Yanzzp/ESP_32/Tempest/OSR2-Pack-June22-password/STLs/OSR2.1/OSR2_1 Main Arm Beta1.stl

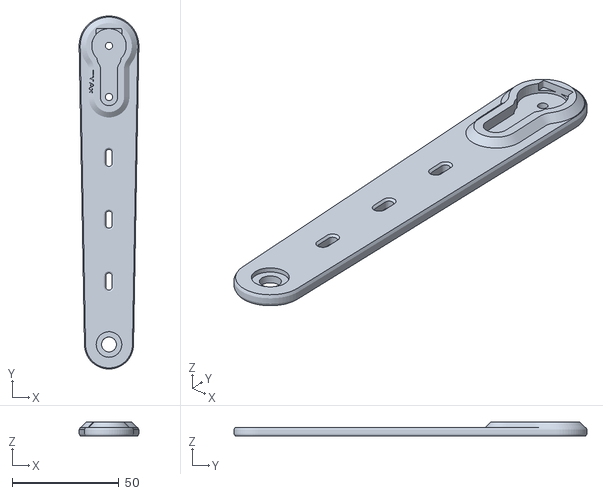
[picture p1: CAD file, 2023-10-18]
Tempest/OSR2-Pack-June22-password/STLs/OSR2.1/OSR2_1 Main Arm Beta1.stl
28.0 x 165.5 x 6.50
