Yanzzp/ESP_32/Tempest/SR6-Pack-June22-password/STLs/SR6 Alternate Parts/SR6 Main Link Alpha1.stl

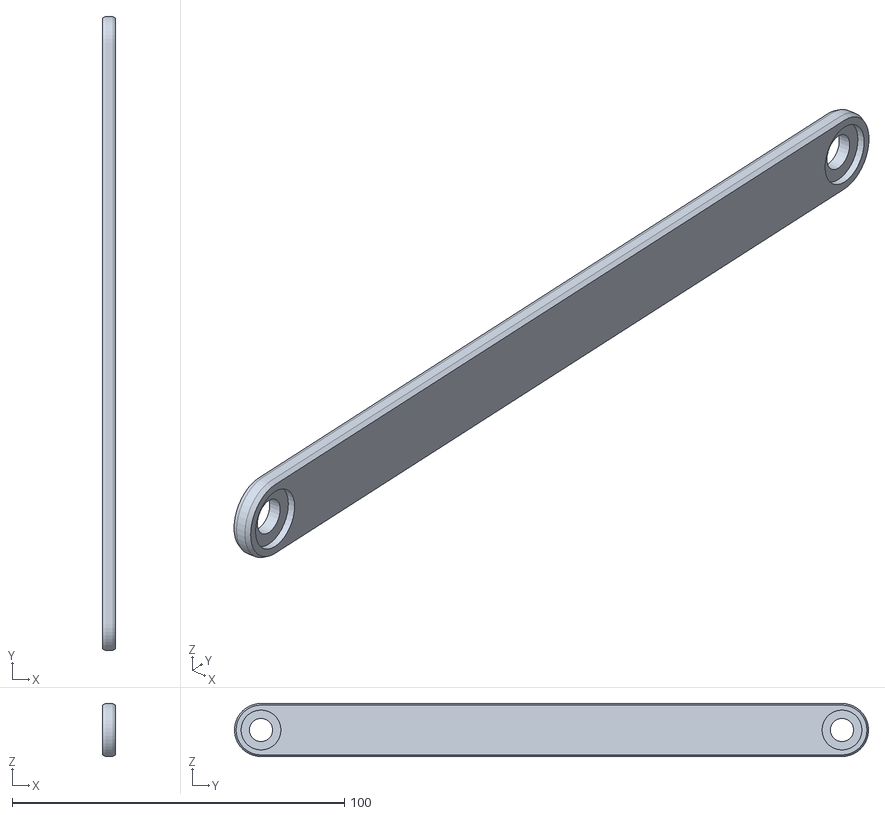
[picture p2: CAD file, 2023-10-18]
Tempest/SR6-Pack-June22-password/STLs/SR6 Alternate Parts/SR6 Main Link Alpha1.stl
4.00 x 191.0 x 16.0
