Yanzzp/ESP_32/Tempest/SR6-Pack-June22-password/STLs/SR6 Beta Parts/SR6 Bearing Main Link Beta1.stl

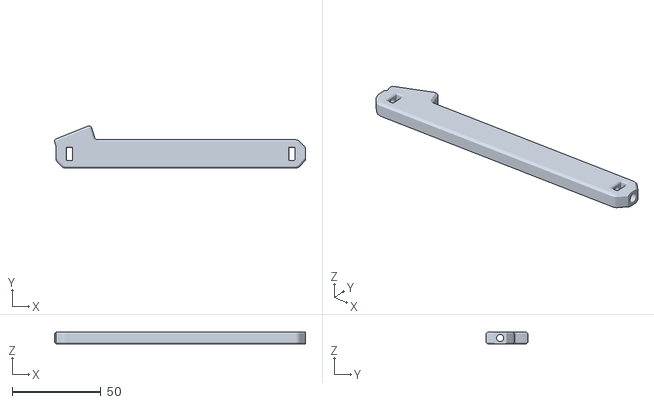
[picture p3: CAD file, 2023-10-18]
Tempest/SR6-Pack-June22-password/STLs/SR6 Beta Parts/SR6 Bearing Main Link Beta1.stl
141.8 x 23.8 x 7.00
