Yanzzp/ESP_32/Tempest/FS Case/FS Case/FS Case Body Alpha1.stl

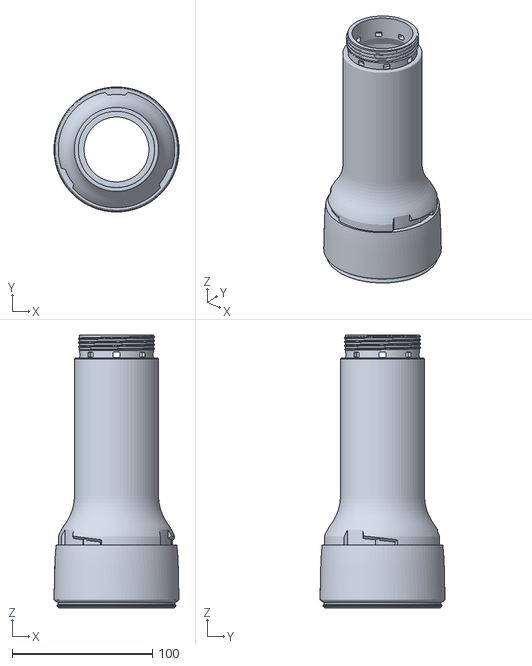
[picture p4: CAD file, 2023-10-18]
Tempest/FS Case/FS Case/FS Case Body Alpha1.stl
89.0 x 89.1 x 194.5
