Yanzzp/ESP_32/Tempest/OSR2-Pack-June22-password/STLs/OSR2 Bearing Arms/OSR2 Bearing Arm Beta1.stl

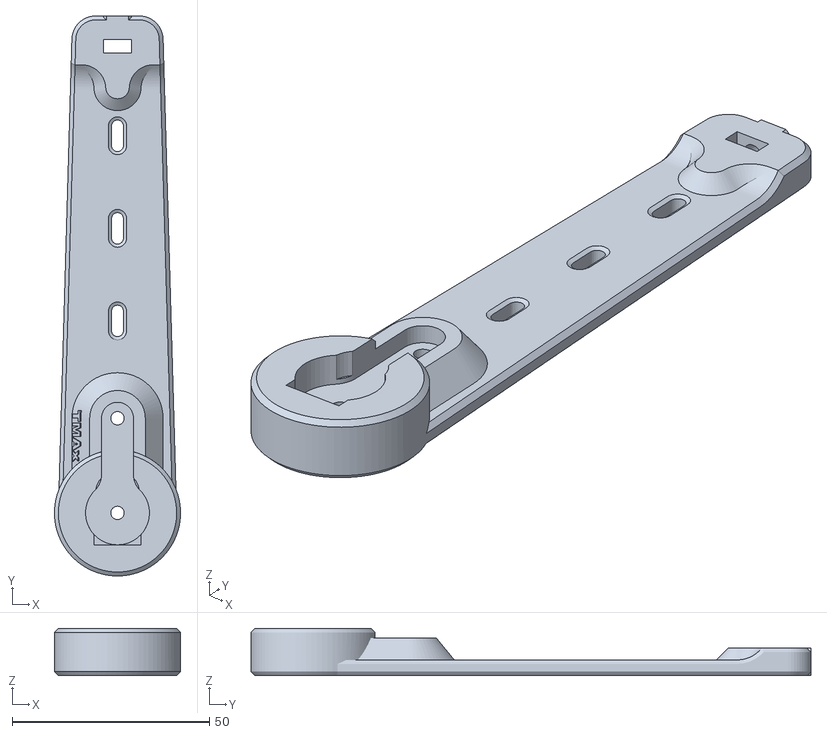
[picture p5: CAD file, 2023-10-18]
Tempest/OSR2-Pack-June22-password/STLs/OSR2 Bearing Arms/OSR2 Bearing Arm Beta1.stl
32.0 x 142.0 x 12.0
