Yanzzp/ESP_32/Tempest/OSR2-Pack-June22-password/STLs/OSR2 Pitcher/OSR2 plus Spacer Beta1.stl

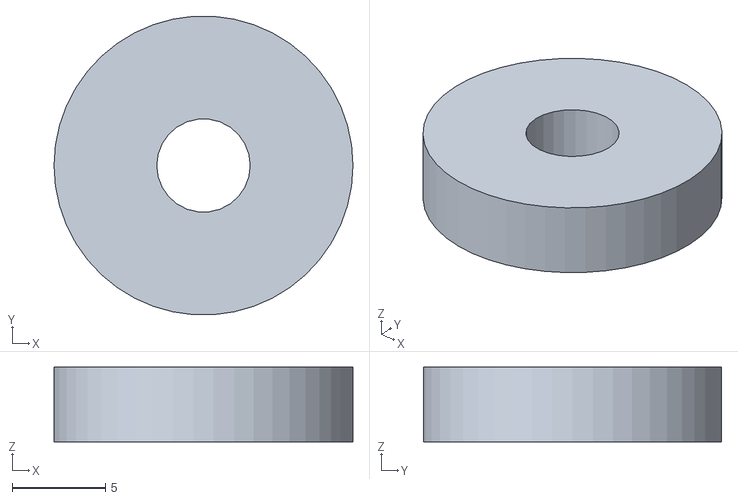
[picture p6: CAD file, 2023-10-18]
Tempest/OSR2-Pack-June22-password/STLs/OSR2 Pitcher/OSR2 plus Spacer Beta1.stl
16.0 x 16.0 x 4.00
