Yanzzp/ESP_32/Tempest/OSR2-Pack-June22-password/STLs/OSR2 T-valve/T-Valve Base Beta3.stl

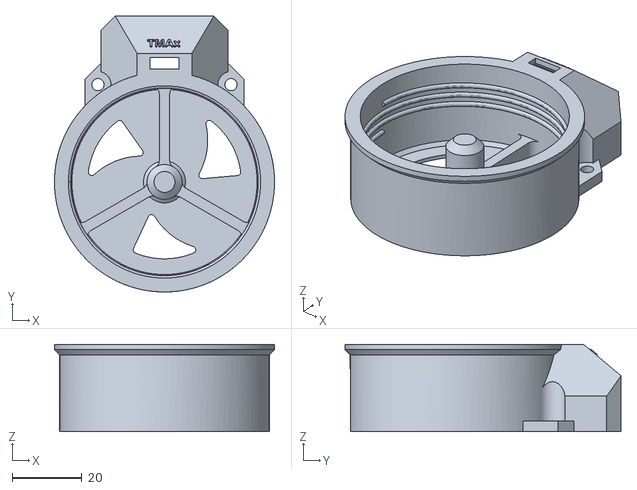
[picture p7: CAD file, 2023-10-18]
Tempest/OSR2-Pack-June22-password/STLs/OSR2 T-valve/T-Valve Base Beta3.stl
63.0 x 79.0 x 25.0
