Yanzzp/ESP_32/Tempest/OSR2-Pack-June22-password/STLs/OSR2 T-wist/T-wist4 Lid Beta1.stl

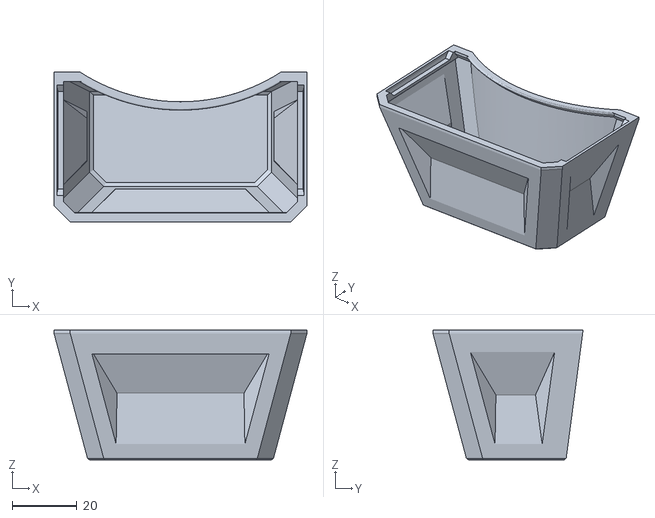
[picture p8: CAD file, 2023-10-18]
Tempest/OSR2-Pack-June22-password/STLs/OSR2 T-wist/T-wist4 Lid Beta1.stl
78.0 x 46.3 x 40.0
