Yanzzp/ESP_32/Tempest/SR6-Pack-June22-password/STLs/SR6 Beta Parts/SR6 L-Pitcher Beta1.stl

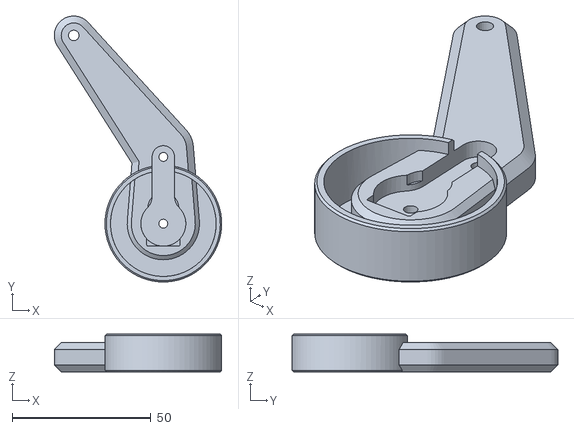
[picture p9: CAD file, 2023-10-18]
Tempest/SR6-Pack-June22-password/STLs/SR6 Beta Parts/SR6 L-Pitcher Beta1.stl
60.2 x 95.7 x 13.5
