Yanzzp/ESP_32/Tempest/SR6-Pack-June22-password/STLs/SR6 Beta Shields/SR6 Blank Shield (cut to desired height).step

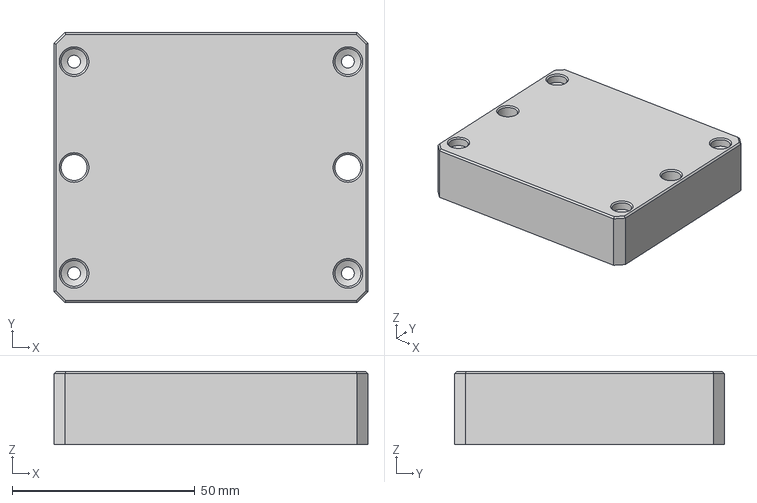
[picture p10: CAD file, 2023-10-18]
Tempest/SR6-Pack-June22-password/STLs/SR6 Beta Shields/SR6 Blank Shield (cut to desired height).step
86.0 x 74.0 x 20.0 mm
