Yanzzp/ESP_32/Tempest/SR6-Pack-June22-password/STLs/SR6 Beta Trays/SR6 Tray XT60E1-M Beta1.stl

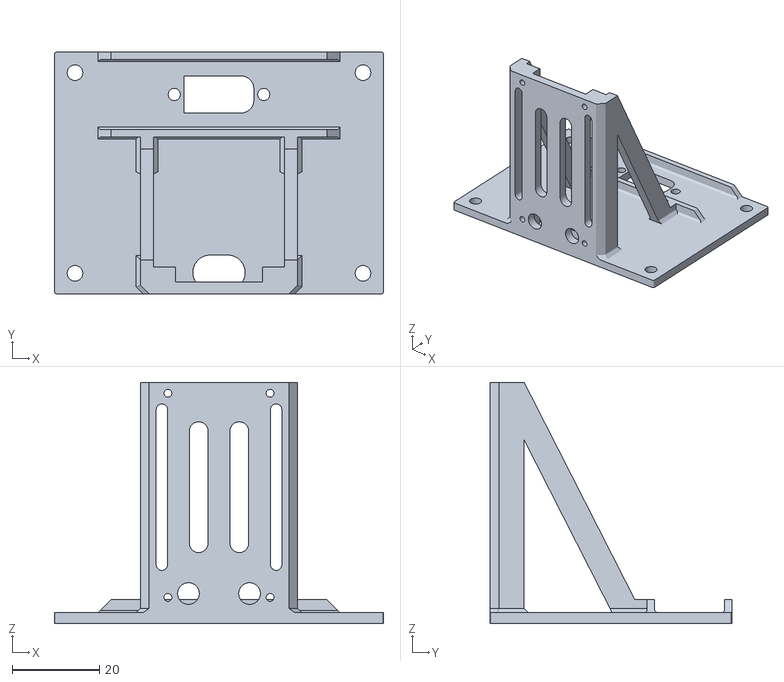
[picture p11: CAD file, 2023-10-18]
Tempest/SR6-Pack-June22-password/STLs/SR6 Beta Trays/SR6 Tray XT60E1-M Beta1.stl
75.4 x 55.4 x 55.3
