Yanzzp/ESP_32/Tempest/FS Case/FS Case/FS Case Cap ALpha1.stl

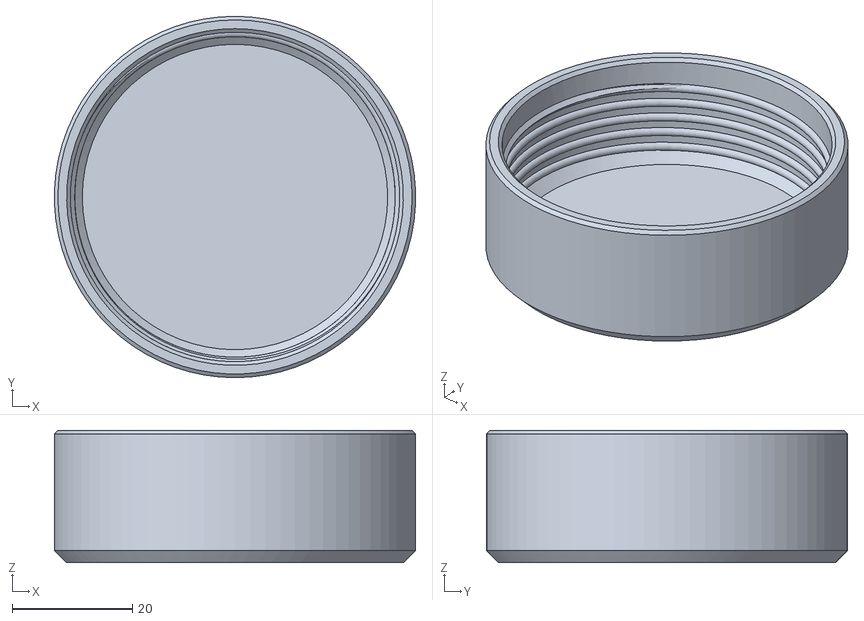
[picture p13: CAD file, 2023-10-18]
Tempest/FS Case/FS Case/FS Case Cap ALpha1.stl
59.9 x 60.0 x 22.0
