Yanzzp/ESP_32/Tempest/OSR2-Pack-June22-password/STLs/OSR2 Bearing Arms/OSR2 4x3mm Spacer Beta1.stl

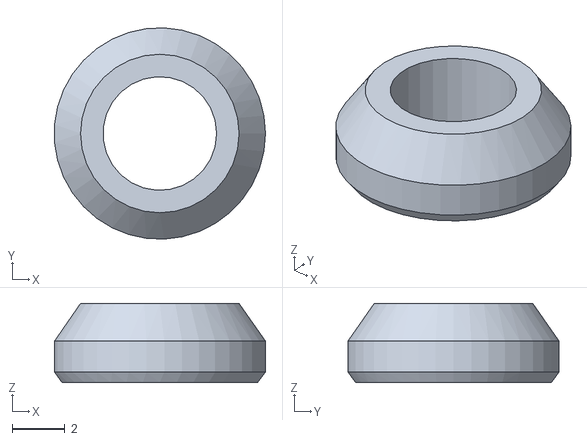
[picture p14: CAD file, 2023-10-18]
Tempest/OSR2-Pack-June22-password/STLs/OSR2 Bearing Arms/OSR2 4x3mm Spacer Beta1.stl
7.99 x 7.99 x 3.00
