Yanzzp/ESP_32/Tempest/OSR2-Pack-June22-password/STLs/OSR2 Pitcher/OSR2 plus Pitcher Beta3.stl

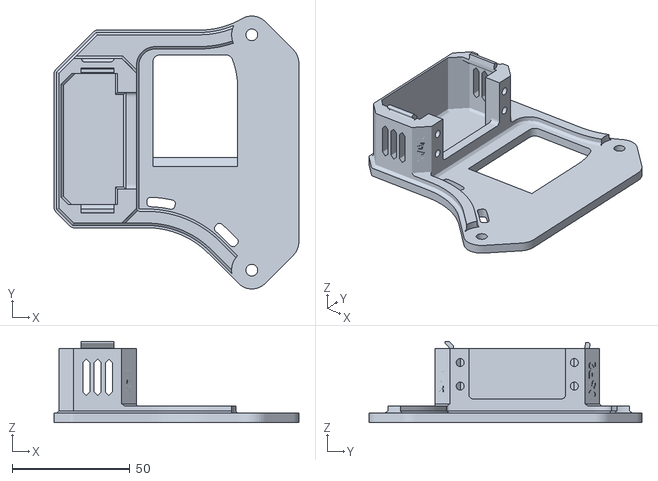
[picture p15: CAD file, 2023-10-18]
Tempest/OSR2-Pack-June22-password/STLs/OSR2 Pitcher/OSR2 plus Pitcher Beta3.stl
104.0 x 116.0 x 34.5
