Yanzzp/ESP_32/Tempest/OSR2-Pack-June22-password/STLs/OSR2 T-valve/T-Valve Blades Beta2.stl

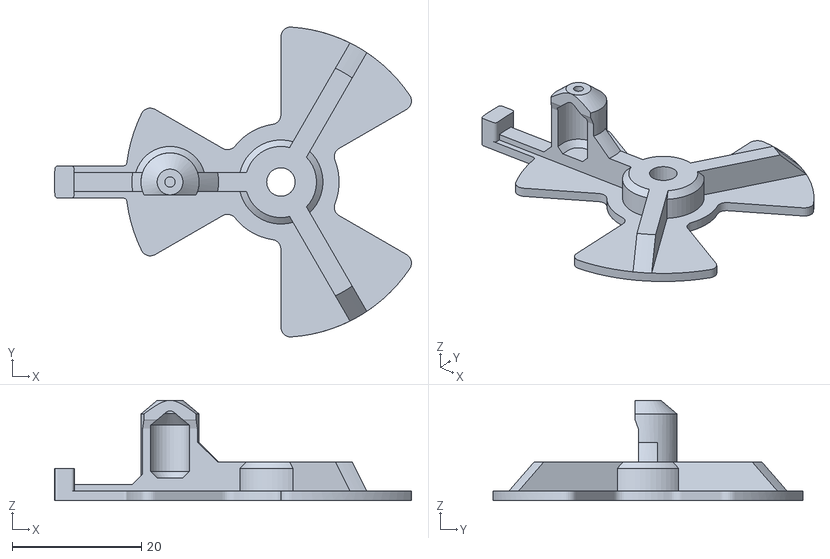
[picture p16: CAD file, 2023-10-18]
Tempest/OSR2-Pack-June22-password/STLs/OSR2 T-valve/T-Valve Blades Beta2.stl
55.2 x 47.9 x 15.5
