Yanzzp/ESP_32/Tempest/OSR2-Pack-June22-password/STLs/OSR2.1/OSR2_1 Receiver Beta1.stl

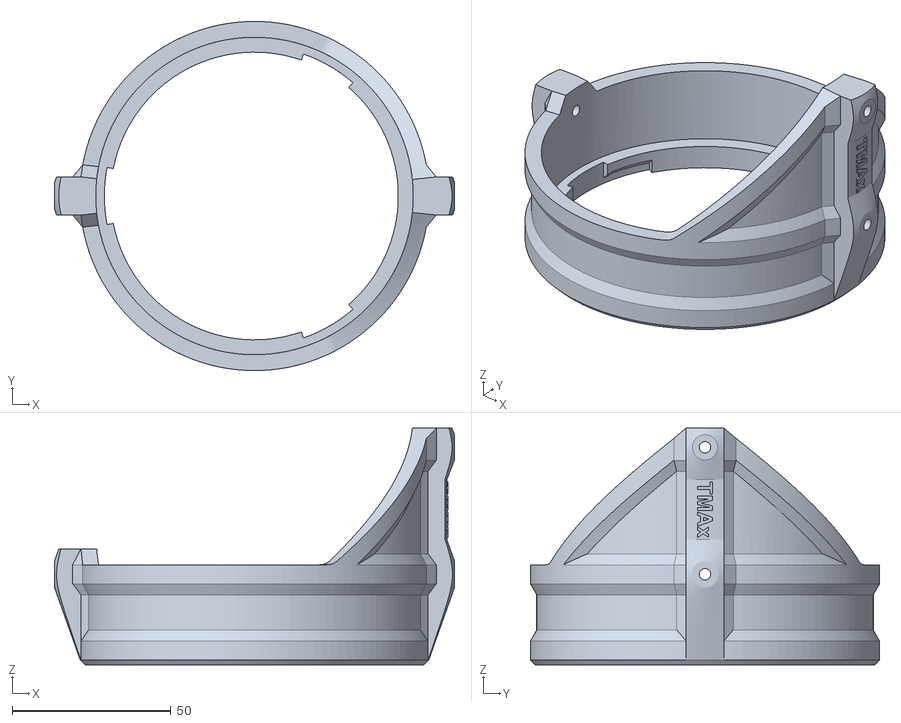
[picture p18: CAD file, 2023-10-18]
Tempest/OSR2-Pack-June22-password/STLs/OSR2.1/OSR2_1 Receiver Beta1.stl
126.0 x 110.0 x 74.5
