Yanzzp/ESP_32/Tempest/SR6-Pack-June22-password/STLs/SR6 Alternate Parts/SR6 Pitcher Link Alpha1.stl

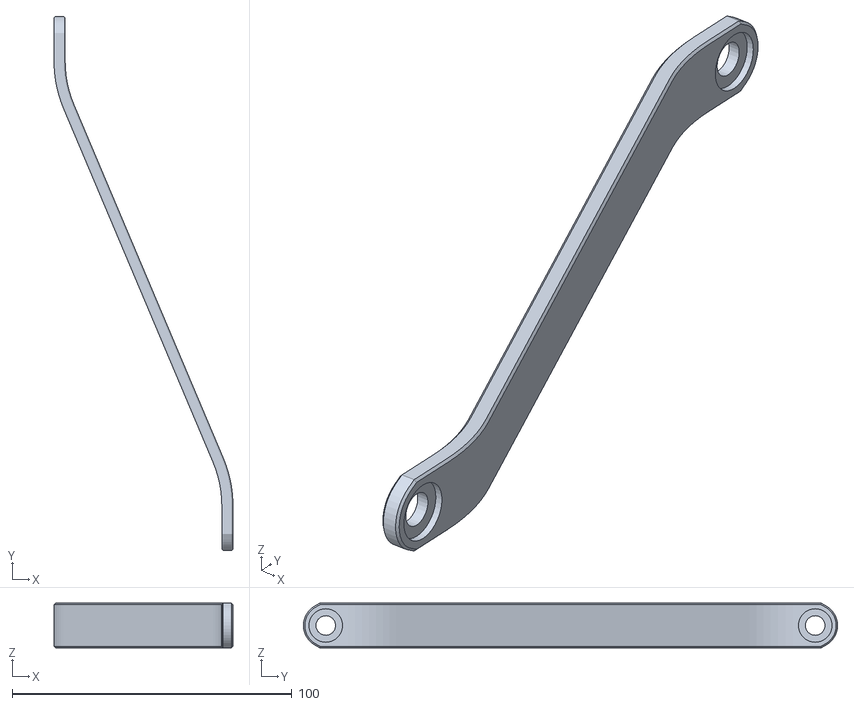
[picture p19: CAD file, 2023-10-18]
Tempest/SR6-Pack-June22-password/STLs/SR6 Alternate Parts/SR6 Pitcher Link Alpha1.stl
64.0 x 191.0 x 16.0
