Yanzzp/ESP_32/Tempest/SR6-Pack-June22-password/STLs/SR6 Beta Parts/SR6 R-Frame Beta1.stl

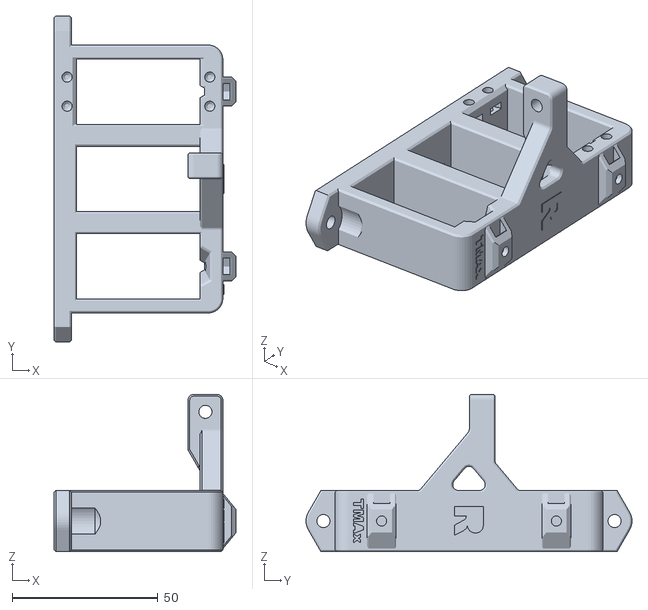
[picture p20: CAD file, 2023-10-18]
Tempest/SR6-Pack-June22-password/STLs/SR6 Beta Parts/SR6 R-Frame Beta1.stl
62.5 x 112.0 x 54.0
