Yanzzp/ESP_32/Tempest/SR6-Pack-June22-password/STLs/SR6 Beta Shields/SR6 Shield 40mm Fan + OLED Display(alternate dimensions).stl

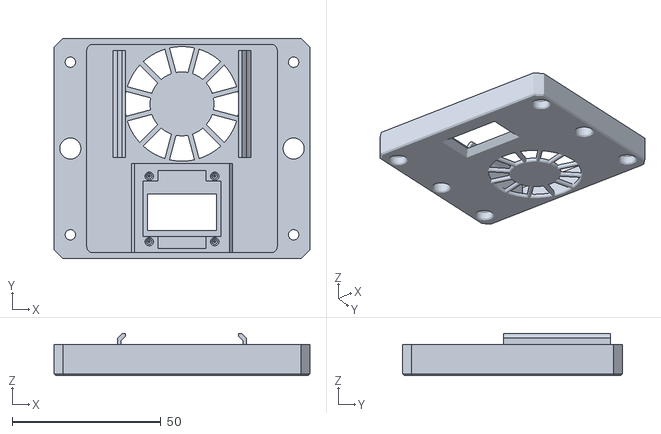
[picture p21: CAD file, 2023-10-18]
Tempest/SR6-Pack-June22-password/STLs/SR6 Beta Shields/SR6 Shield 40mm Fan + OLED Display(alternate dimensions).stl
86.0 x 74.0 x 14.1
