Yanzzp/ESP_32/Tempest/SR6-Pack-June22-password/STLs/SR6 Beta Trays/SR6 Tray Standard Beta1.step

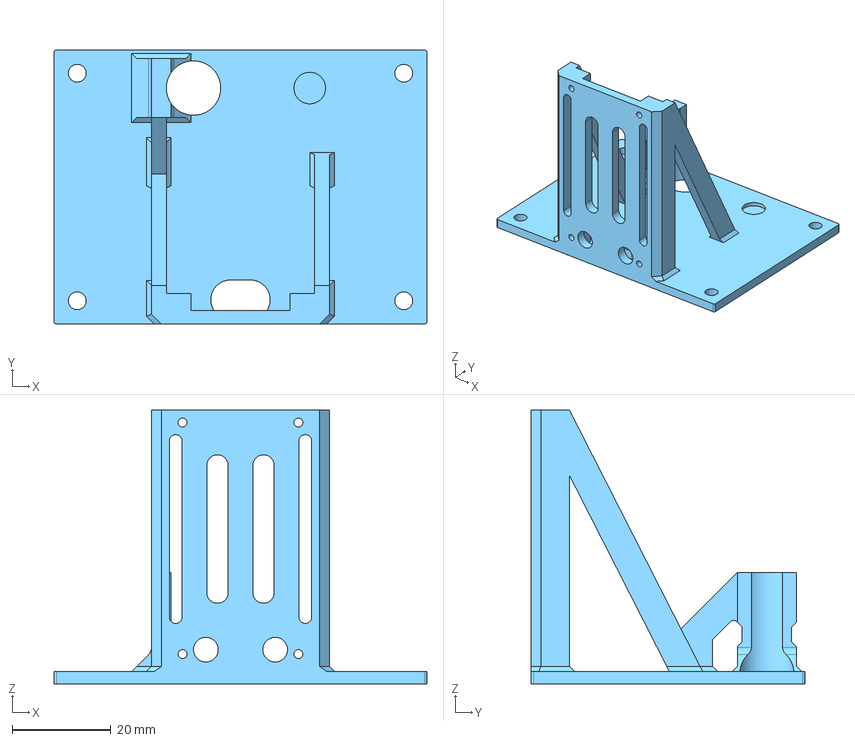
[picture p22: CAD file, 2023-10-18]
Tempest/SR6-Pack-June22-password/STLs/SR6 Beta Trays/SR6 Tray Standard Beta1.step
75.4 x 55.4 x 55.3 mm
