Yanzzp/ESP_32/Tempest/SR6-Pack-June22-password/STLs/SR6 T-wist4/T-wist Exchange Gear Beta1.stl

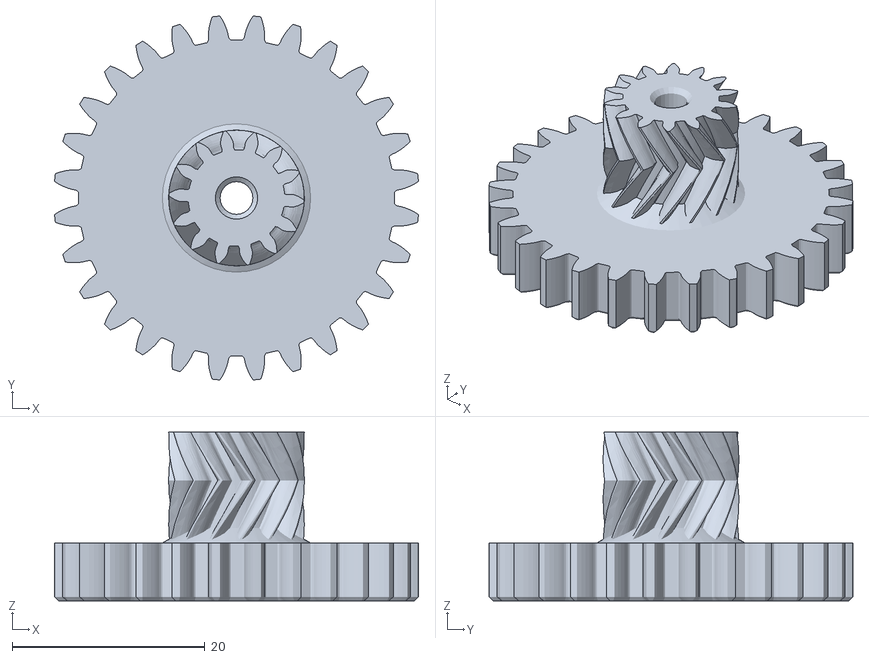
[picture p23: CAD file, 2023-10-18]
Tempest/SR6-Pack-June22-password/STLs/SR6 T-wist4/T-wist Exchange Gear Beta1.stl
37.8 x 37.8 x 17.5
