Yanzzp/ESP_32/Tempest/FS Case/FS Case/FS Case Cover Alpha1.stl

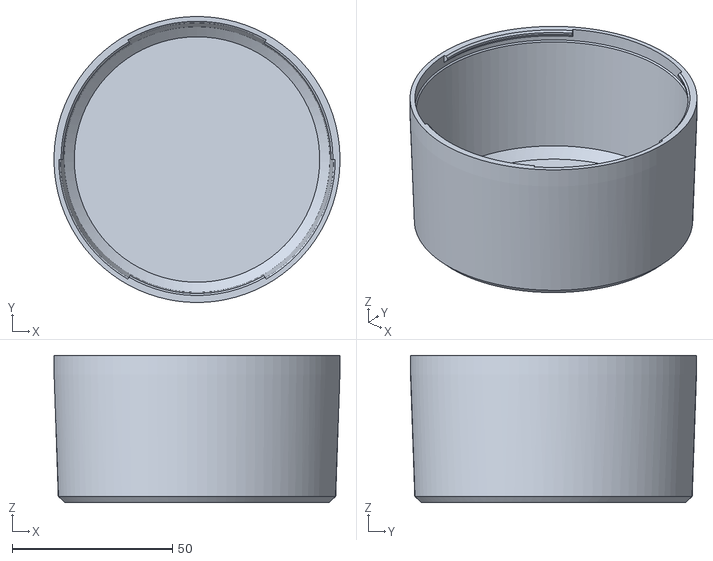
[picture p24: CAD file, 2023-10-18]
Tempest/FS Case/FS Case/FS Case Cover Alpha1.stl
89.1 x 89.2 x 46.0
