Yanzzp/ESP_32/Tempest/OSR2-Pack-June22-password/STLs/OSR2 Pitcher/OSR2 plus Pitcher Arm Beta2.stl

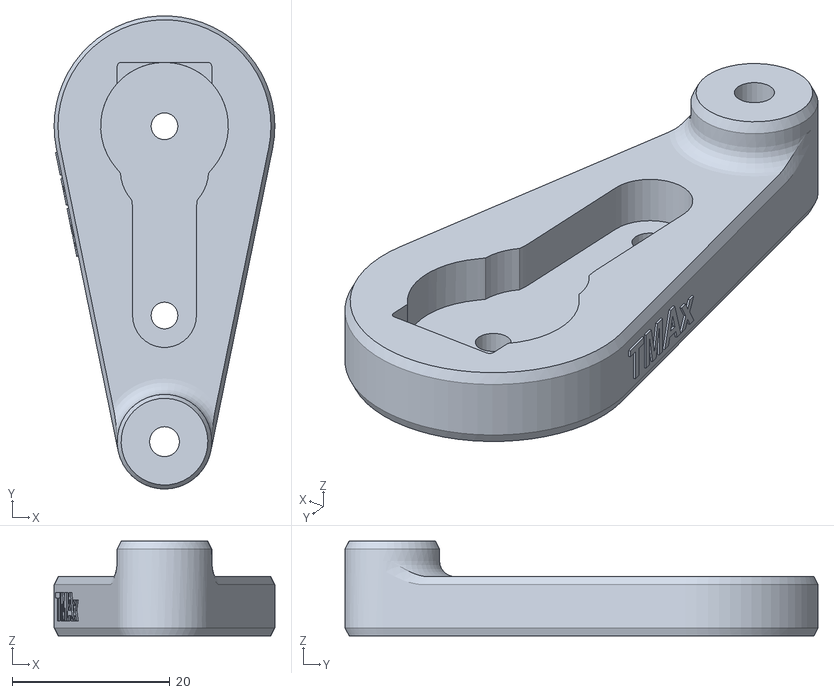
[picture p26: CAD file, 2023-10-18]
Tempest/OSR2-Pack-June22-password/STLs/OSR2 Pitcher/OSR2 plus Pitcher Arm Beta2.stl
28.0 x 60.0 x 12.0
