Yanzzp/ESP_32/Tempest/OSR2-Pack-June22-password/STLs/OSR2 T-valve/T-Valve Cover Beta3.stl

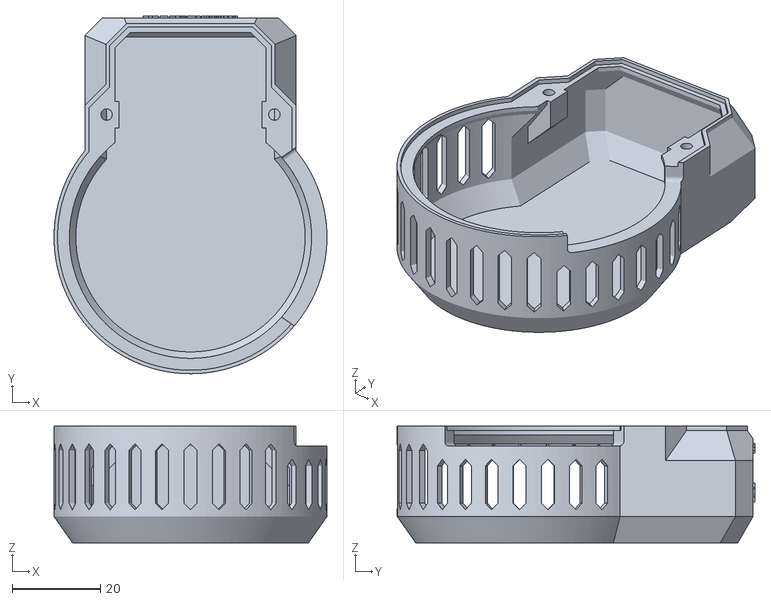
[picture p27: CAD file, 2023-10-18]
Tempest/OSR2-Pack-June22-password/STLs/OSR2 T-valve/T-Valve Cover Beta3.stl
62.0 x 81.2 x 26.5
