Yanzzp/ESP_32/Tempest/OSR2-Pack-June22-password/STLs/OSR2 T-wist/T-wist4 Drive Gear Beta1.stl

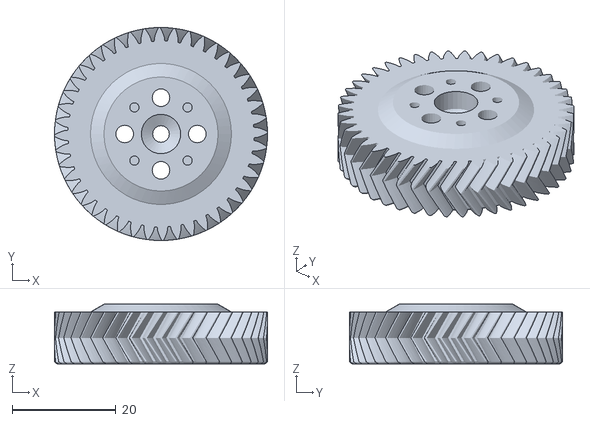
[picture p28: CAD file, 2023-10-18]
Tempest/OSR2-Pack-June22-password/STLs/OSR2 T-wist/T-wist4 Drive Gear Beta1.stl
41.1 x 41.1 x 11.5
