Yanzzp/ESP_32/Tempest/OSR2-Pack-June22-password/STLs/OSR2.1/OSR2_1 Support Arm Beta1.stl

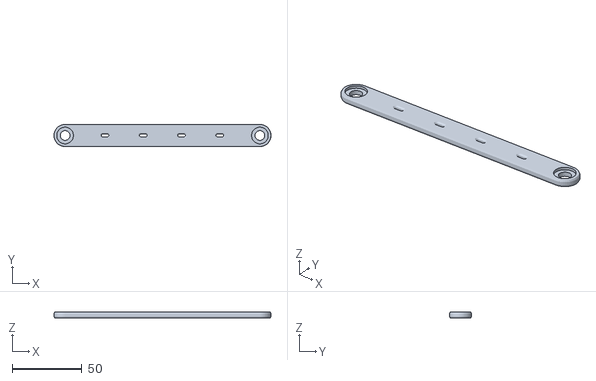
[picture p29: CAD file, 2023-10-18]
Tempest/OSR2-Pack-June22-password/STLs/OSR2.1/OSR2_1 Support Arm Beta1.stl
156.0 x 16.0 x 4.00
