Yanzzp/ESP_32/Tempest/SR6-Pack-June22-password/STLs/SR6 Alternate Parts/SR6 Window Lid Beta1.stl

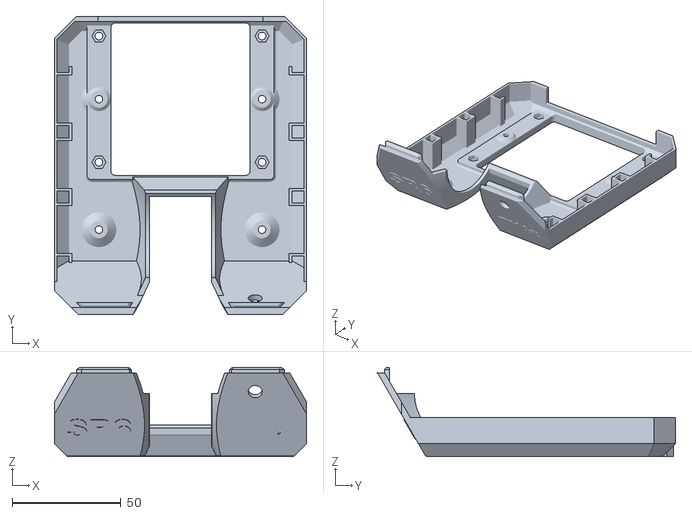
[picture p30: CAD file, 2023-10-18]
Tempest/SR6-Pack-June22-password/STLs/SR6 Alternate Parts/SR6 Window Lid Beta1.stl
116.0 x 137.0 x 41.1
