Yanzzp/ESP_32/Tempest/SR6-Pack-June22-password/STLs/SR6 Beta Parts/SR6 Bearing Pitcher Link Beta1.stl

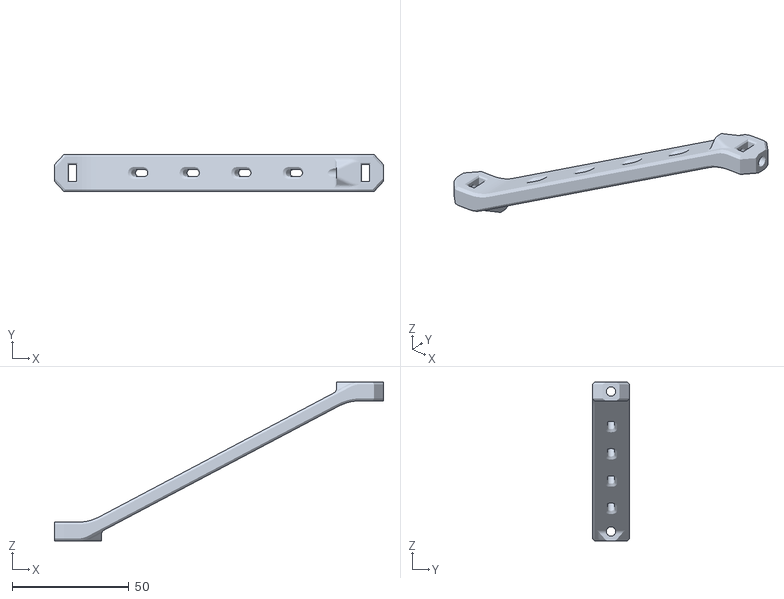
[picture p31: CAD file, 2023-10-18]
Tempest/SR6-Pack-June22-password/STLs/SR6 Beta Parts/SR6 Bearing Pitcher Link Beta1.stl
141.0 x 16.0 x 68.0
