Yanzzp/ESP_32/Tempest/OSR2-Pack-June22-password/STLs/OSR2 Bearing Arms/OSR2 Bearing Conduit Link Beta1.stl

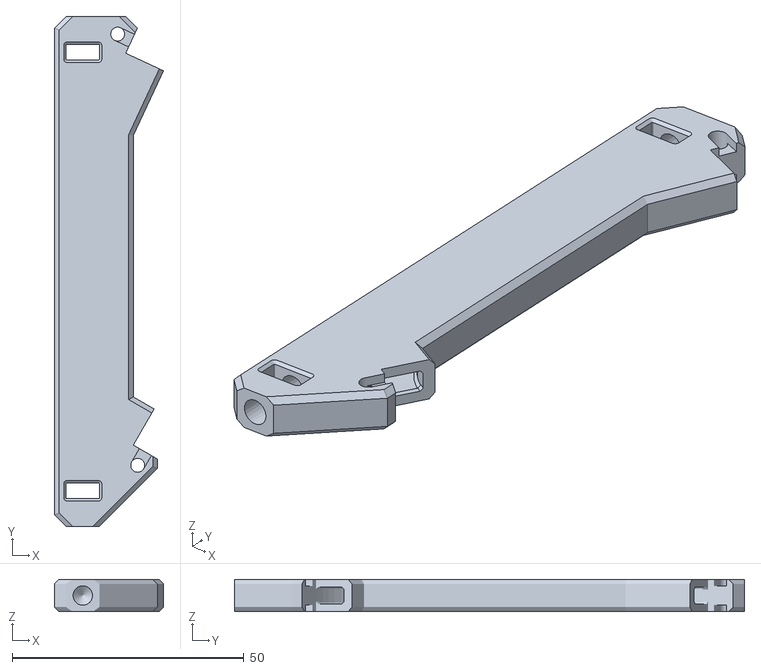
[picture p32: CAD file, 2023-10-18]
Tempest/OSR2-Pack-June22-password/STLs/OSR2 Bearing Arms/OSR2 Bearing Conduit Link Beta1.stl
23.5 x 110.0 x 7.00
