Yanzzp/ESP_32/Tempest/OSR2-Pack-June22-password/STLs/OSR2 Pitcher/OSR2 plus Pitcher Lid Beta2.stl

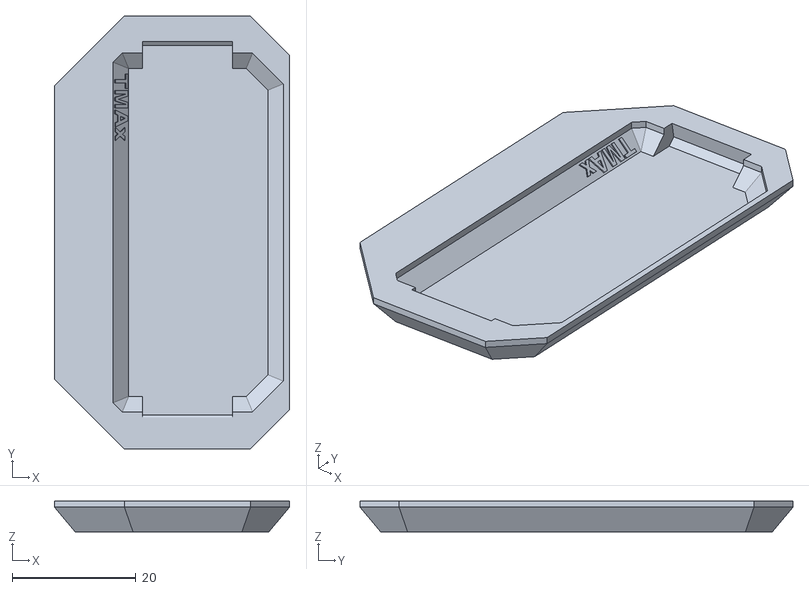
[picture p33: CAD file, 2023-10-18]
Tempest/OSR2-Pack-June22-password/STLs/OSR2 Pitcher/OSR2 plus Pitcher Lid Beta2.stl
38.0 x 70.0 x 5.00
