Yanzzp/ESP_32/Tempest/OSR2-Pack-June22-password/STLs/OSR2 T-wist/T-wist Clip Ring Gear Beta4.stl

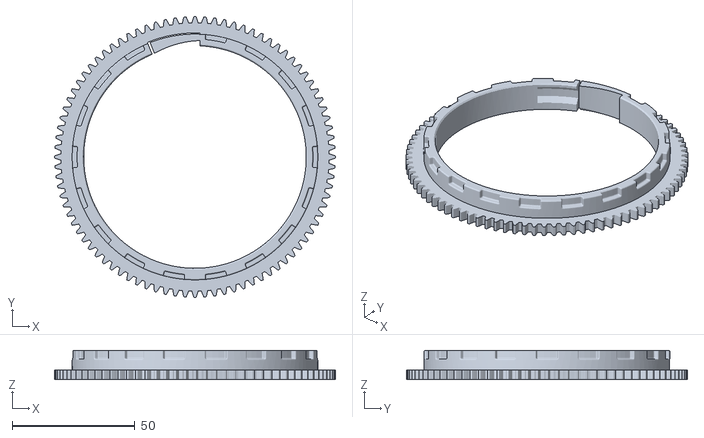
[picture p34: CAD file, 2023-10-18]
Tempest/OSR2-Pack-June22-password/STLs/OSR2 T-wist/T-wist Clip Ring Gear Beta4.stl
114.4 x 114.4 x 12.0
