Yanzzp/ESP_32/Tempest/OSR2-Pack-June22-password/STLs/OSR2.1/OSR2_1 Lid Beta1.stl

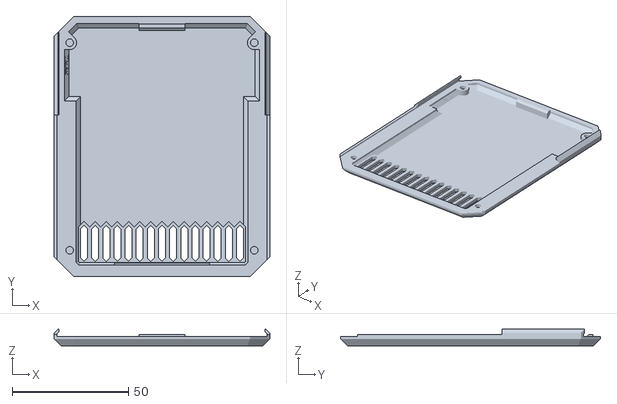
[picture p35: CAD file, 2023-10-18]
Tempest/OSR2-Pack-June22-password/STLs/OSR2.1/OSR2_1 Lid Beta1.stl
93.0 x 112.0 x 7.20
