Yanzzp/ESP_32/Tempest/SR6-Pack-June22-password/STLs/SR6 Beta Parts/SR6 Base Beta1A.stl

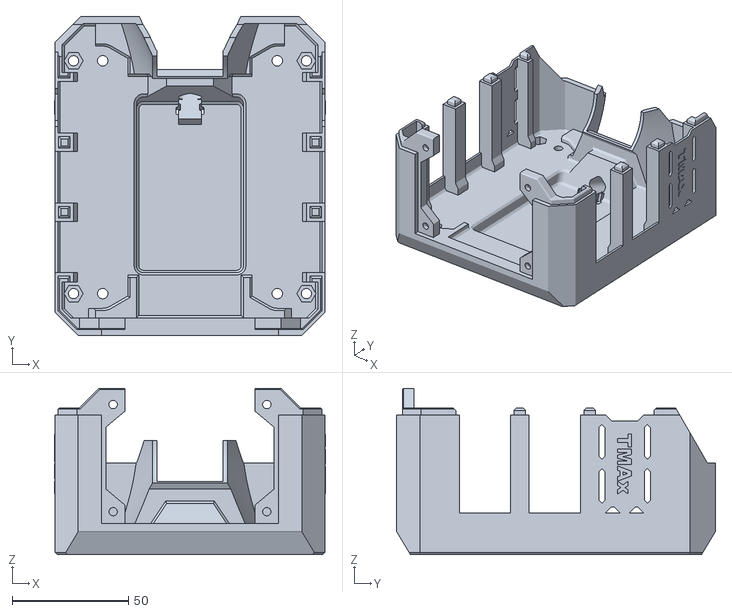
[picture p36: CAD file, 2023-10-18]
Tempest/SR6-Pack-June22-password/STLs/SR6 Beta Parts/SR6 Base Beta1A.stl
116.6 x 137.0 x 71.5
