Yanzzp/ESP_32/Tempest/OSR2-Pack-June22-password/STLs/OSR2 T-wist/T-wist4 OSR2 Base Beta1.stl

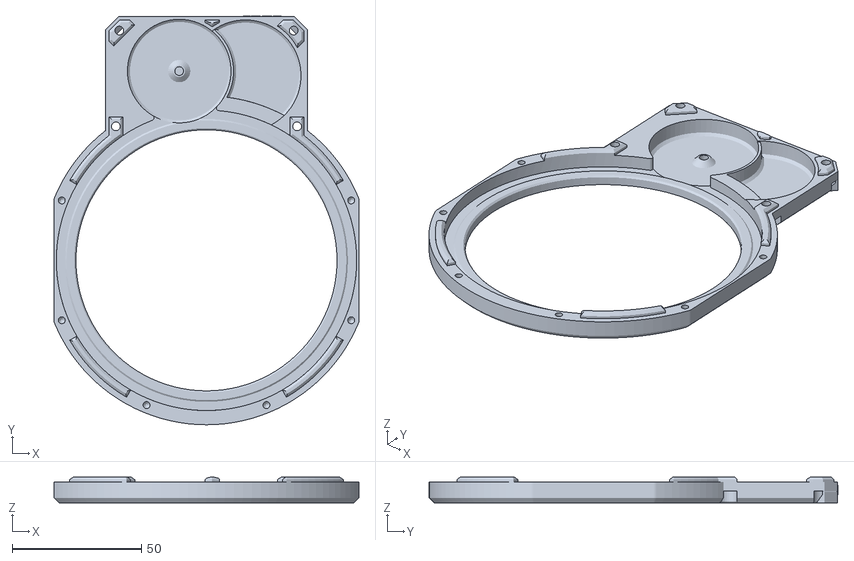
[picture p37: CAD file, 2023-10-18]
Tempest/OSR2-Pack-June22-password/STLs/OSR2 T-wist/T-wist4 OSR2 Base Beta1.stl
117.8 x 157.8 x 10.0
