Yanzzp/ESP_32/Tempest/OSR2-Pack-June22-password/STLs/OSR2.1/OSR2_1 Base Beta1 (Romeo BLE Mini).stl

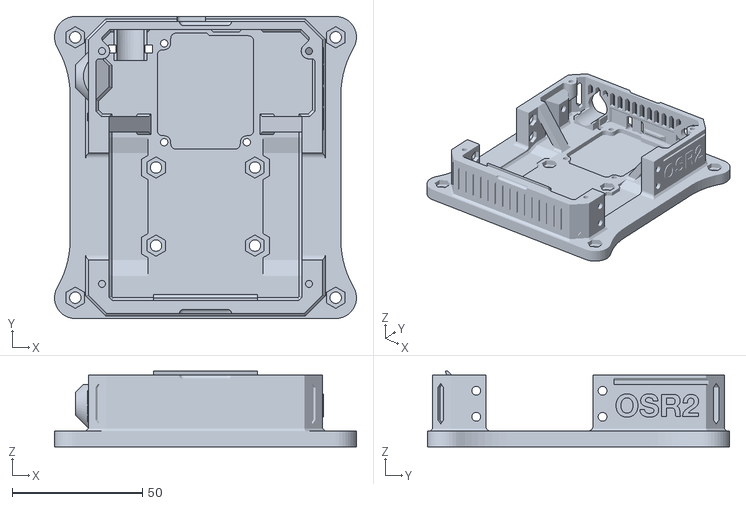
[picture p38: CAD file, 2023-10-18]
Tempest/OSR2-Pack-June22-password/STLs/OSR2.1/OSR2_1 Base Beta1 (Romeo BLE Mini).stl
116.0 x 116.0 x 29.0
