Yanzzp/ESP_32/Tempest/SR6-Pack-June22-password/STLs/SR6 T-wist4/SR6 Grommet Pitcher Link Beta1.stl

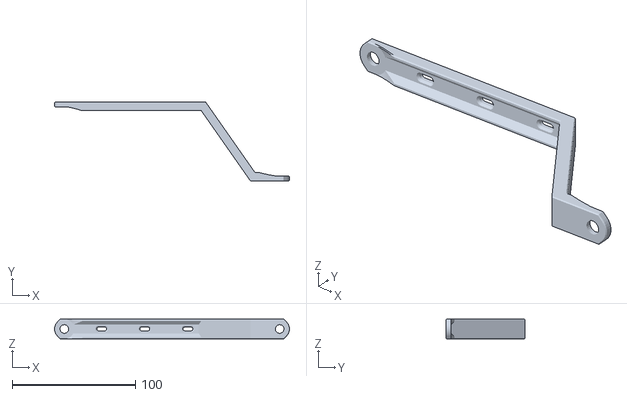
[picture p40: CAD file, 2023-10-18]
Tempest/SR6-Pack-June22-password/STLs/SR6 T-wist4/SR6 Grommet Pitcher Link Beta1.stl
191.0 x 64.0 x 16.0
