Yanzzp/ESP_32/Tempest/SR6-Pack-June22-password/STLs/SR6 Beta Parts/SR6 Receiver Beta1.stl

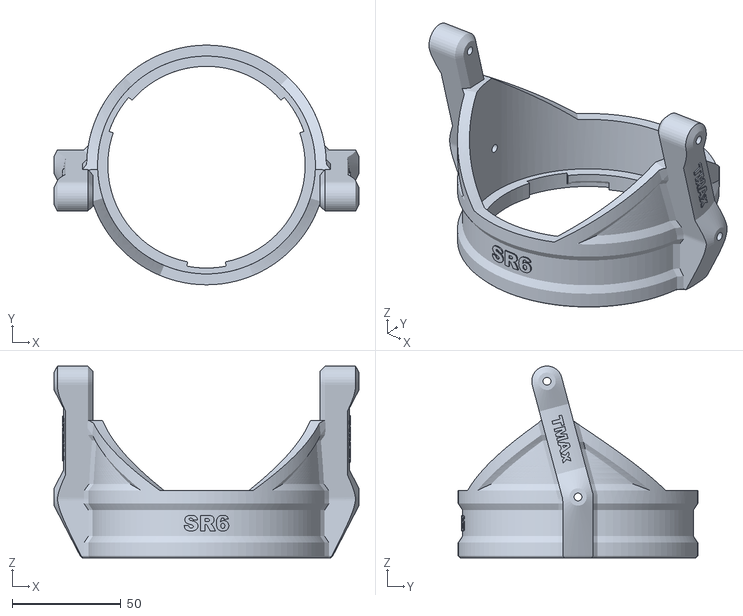
[picture p41: CAD file, 2023-10-18]
Tempest/SR6-Pack-June22-password/STLs/SR6 Beta Parts/SR6 Receiver Beta1.stl
140.0 x 110.0 x 88.1
