Yanzzp/ESP_32/Tempest/SR6-Pack-June22-password/STLs/SR6 T-wist4/SR6 L-Pitcher Angle Link Beta1.stl

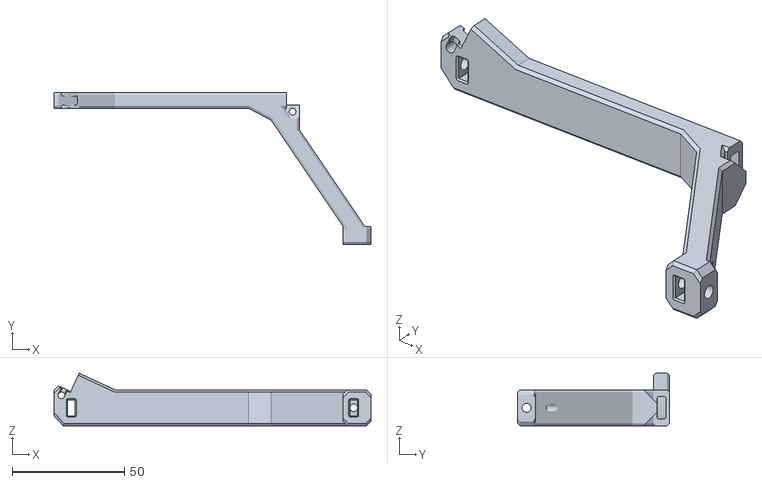
[picture p42: CAD file, 2023-10-18]
Tempest/SR6-Pack-June22-password/STLs/SR6 T-wist4/SR6 L-Pitcher Angle Link Beta1.stl
141.0 x 67.5 x 23.4
