Yanzzp/ESP_32/Tempest/SR6-Pack-June22-password/STLs/SR6 T-wist4/T-wist4 SR6 Body Beta1.stl

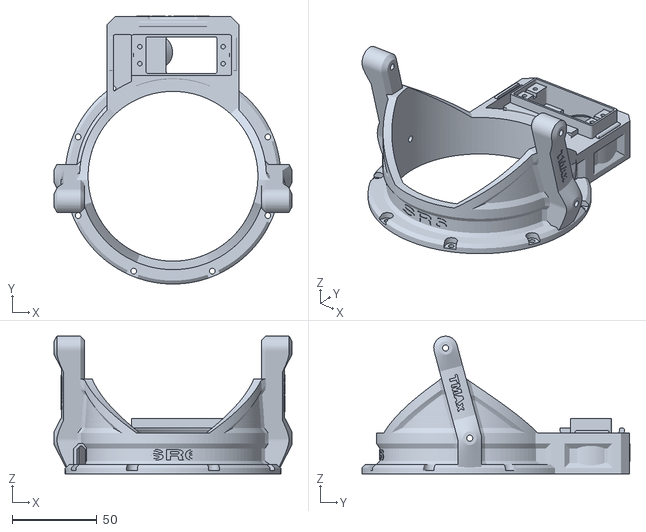
[picture p44: CAD file, 2023-10-18]
Tempest/SR6-Pack-June22-password/STLs/SR6 T-wist4/T-wist4 SR6 Body Beta1.stl
140.0 x 157.9 x 81.1
