Yanzzp/ESP_32/Tempest/SR6-Pack-June22-password/STLs/SR6 Beta Parts/SR6 Power Bus Holder Beta1.stl

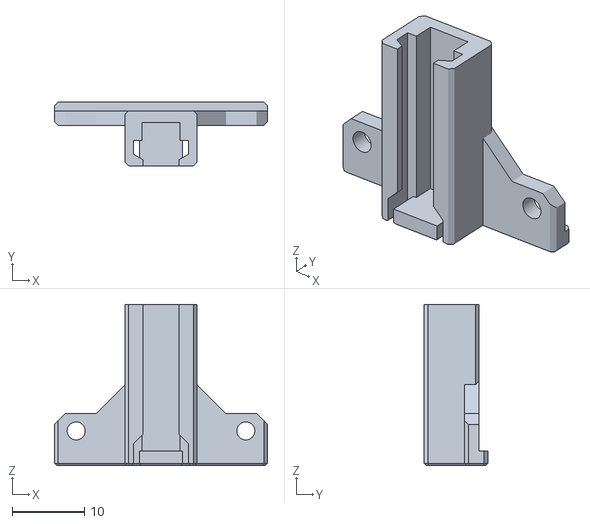
[picture p45: CAD file, 2023-10-18]
Tempest/SR6-Pack-June22-password/STLs/SR6 Beta Parts/SR6 Power Bus Holder Beta1.stl
29.5 x 8.80 x 22.3
