Yanzzp/ESP_32/Tempest/SR6-Pack-June22-password/STLs/SR6 T-wist4/T-wist4 SR6 Base Beta1.stl

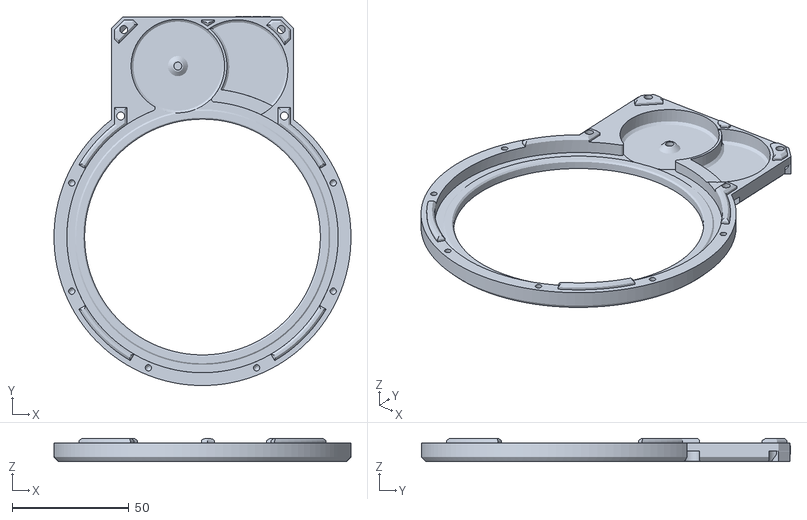
[picture p46: CAD file, 2023-10-18]
Tempest/SR6-Pack-June22-password/STLs/SR6 T-wist4/T-wist4 SR6 Base Beta1.stl
127.0 x 157.8 x 10.0
