Yanzzp/ESP_32/(list of files, cad)

Other CAD files:
Tempest/SR6-Pack-June22-password/STLs/SR6 Beta Shields/SR6 Shield 40mm Fan.stl
Tempest/SR6-Pack-June22-password/STLs/SR6 Beta Shields/SR6 Shield 40mm Fan + OLED Display.stl
Tempest/OSR2-Pack-June22-password/STLs/OSR2.1/OSR2_1 Base Beta1 (ESP32 Devkit1).stl
Tempest/SR6-Pack-June22-password/STLs/SR6 Beta Parts/SR6 R-Pitcher Beta1.stl
Tempest/SR6-Pack-June22-password/STLs/SR6 Beta Trays/SR6 Tray Screw Jack Beta1.stl
Tempest/SR6-Pack-June22-password/STLs/SR6 Beta Trays/SR6 Tray Standard Beta1.stl
